miklasiu/ami_rtc/pic/3d printer as a CNC.jpg

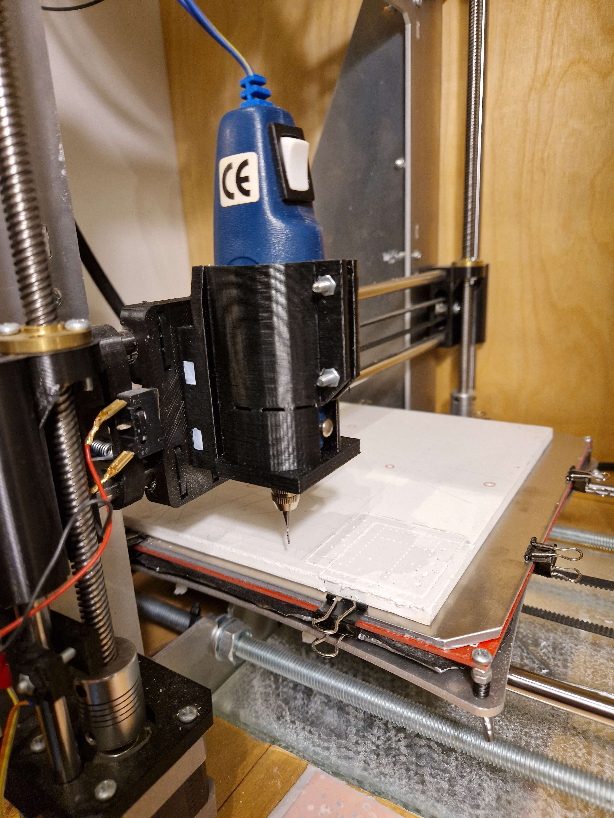
pic/3d printer as a CNC.jpg
