miklasiu/ami_rtc/pic/RTC initial board.jpg

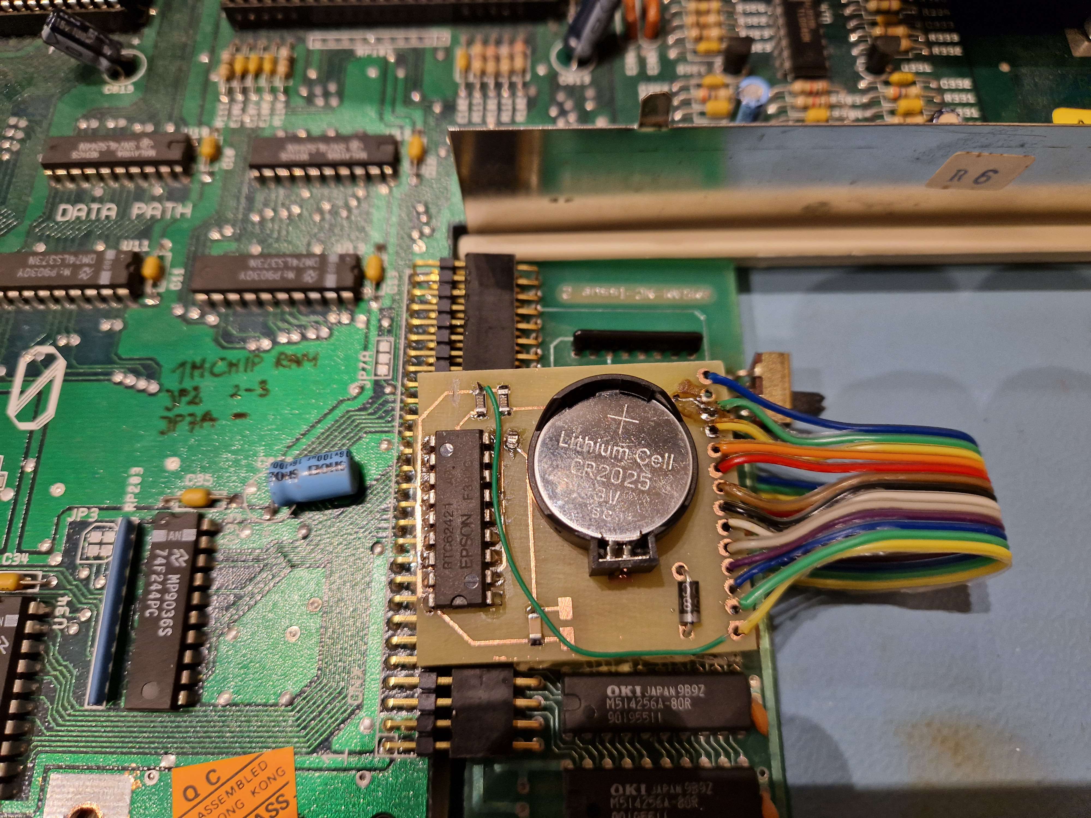
pic/RTC initial board.jpg
