miklasiu/ami_rtc/README.md

# ami_rtc
 Amiga 500 RTC module using EPSON RTC62421A chip.
