miklasiu/ami_rtc/fab/readme.md

Bunch of fabrication outputs used to generate SVG to print traces on a laser printer and to create .gcode for marlin firmware 3d printer with 0.8mm milling cutter. (Like this one: https://allegro.pl/oferta/frez-diamentowy-wieloostrzowy-pcb-0-8-x-3-175-x-38-9780308540)

To add marlin compatible feed rates to FlatCAM gcode files I created a tiny script: https://github.com/miklasiu/wiertarka

Printer Z=0 should be ~1mm below PCB surface. Travel at 7mm above "0" - so around 3-4 mm above PCB. Travel speed 40mm/s, drilling 1mm/s, milling 1/4mm/s

dziurki = holes; ramka = frame (cutout)
