miklasiu/ami_rtc/ami_rtc.kicad_pcb

## KiCad design ami_rtc.kicad_pcb (2024-01-06)

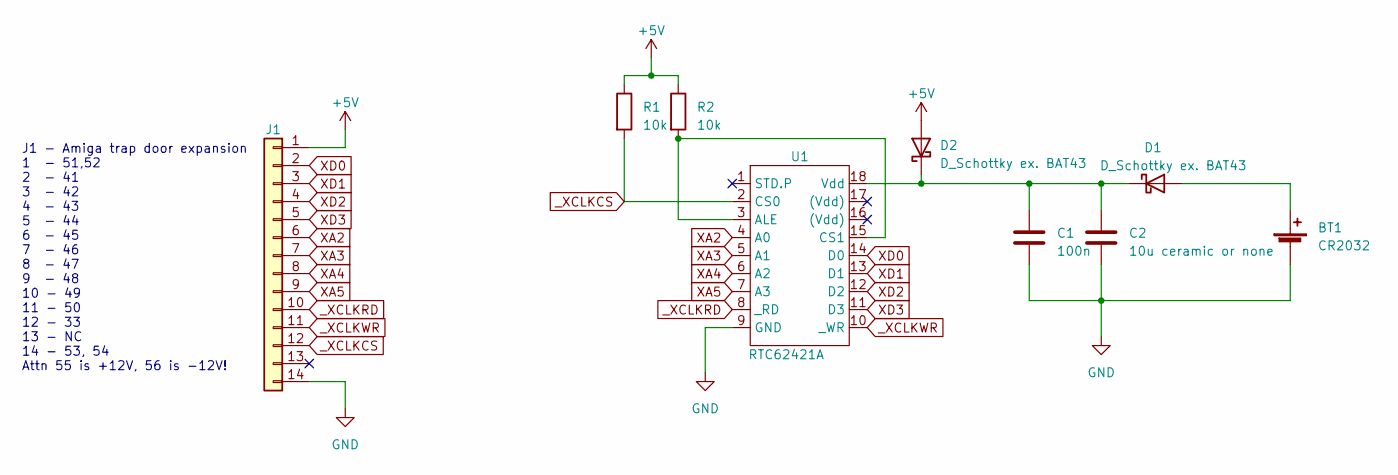
[picture p3: schematic ami_rtc.kicad_sch]

Parts:
BT1: CR2032; BatteryHolder_Keystone_103_1x20mm
C1: 100n; C_1206_3216Metric_Pad1.33x1.80mm_HandSolder
C2: 10u ceramic or none; C_1812_4532Metric_Pad1.57x3.40mm_HandSolder
D1, D2: D_Schottky ex. BAT43; D_DO-35_SOD27_P7.62mm_Horizontal
J1: Conn_01x14; PinHeader_1x14_P2.54mm_Vertical
R1, R2: 10k; R_1206_3216Metric_Pad1.30x1.75mm_HandSolder
U1: RTC62421A; DIP-18_W7.62mm_LongPads

Connections:
+5V: D2.2 (A), J1.1, R1.1, R2.1
GND: BT1.2 (-), C1.2, C2.2, J1.14, U1.9 (GND)
unnamed: BT1.1 (+), D1.2 (A)
unnamed: C1.1, C2.1, D1.1 (K), D2.1 (K), U1.18 (Vdd)
unnamed: R2.2, U1.3 (ALE), U1.15 (CS1)
XA2: J1.6, U1.4 (A0)
XA3: J1.7, U1.5 (A1)
XA4: J1.8, U1.6 (A2)
XA5: J1.9, U1.7 (A3)
XD0: J1.2, U1.14 (D0)
XD1: J1.3, U1.13 (D1)
XD2: J1.4, U1.12 (D2)
XD3: J1.5, U1.11 (D3)
_XCLKCS: J1.12, R1.2, U1.2 (CS0)
_XCLKRD: J1.10, U1.8 (_RD)
_XCLKWR: J1.11, U1.10 (_WR)

Notes on the sheet:
J1 - Amiga trap door expansion 1 - 51,52 2 - 41 3 - 42 4 - 43 5 - 44 6 - 45 7 - 46 8 - 47 9 - 48 10 - 49 11 - 50 12 - 33 13 - NC 14 - 53, 54 Attn 55 is +12V, 56 is -12V!

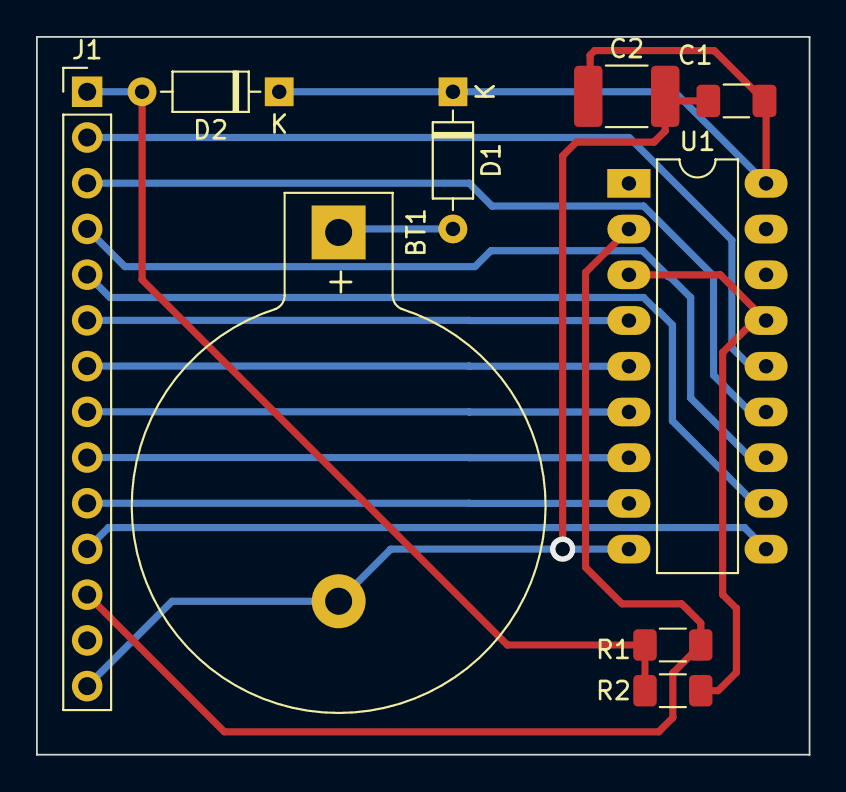
[picture p4: board ami_rtc.kicad_pcb from above]

Board: 2 copper layers, 42.9 x 39.9 mm, 9 parts (0 on the bottom side), 16 nets.
