miklasiu/ami_rtc/(commit log)

2024-01-06 It works! ;)
    [ami_rtc-B_Cu.gbr, ami_rtc-Edge_Cuts.gbr, ami_rtc-F_Cu.gbr, ami_rtc-NPTH-drl.gbr, ami_rtc-NPTH.drl, ami_rtc-PTH-drl.gbr, ami_rtc-PTH.drl, ami_rtc-job.gbrjob]
2024-01-06 Ignore kicad backups
